KentumRIT/Lab-Air-Setup/Current-Loop-and-Pneumatic-Calibration/Images/Figures/RegulatorTransducerShielded.png

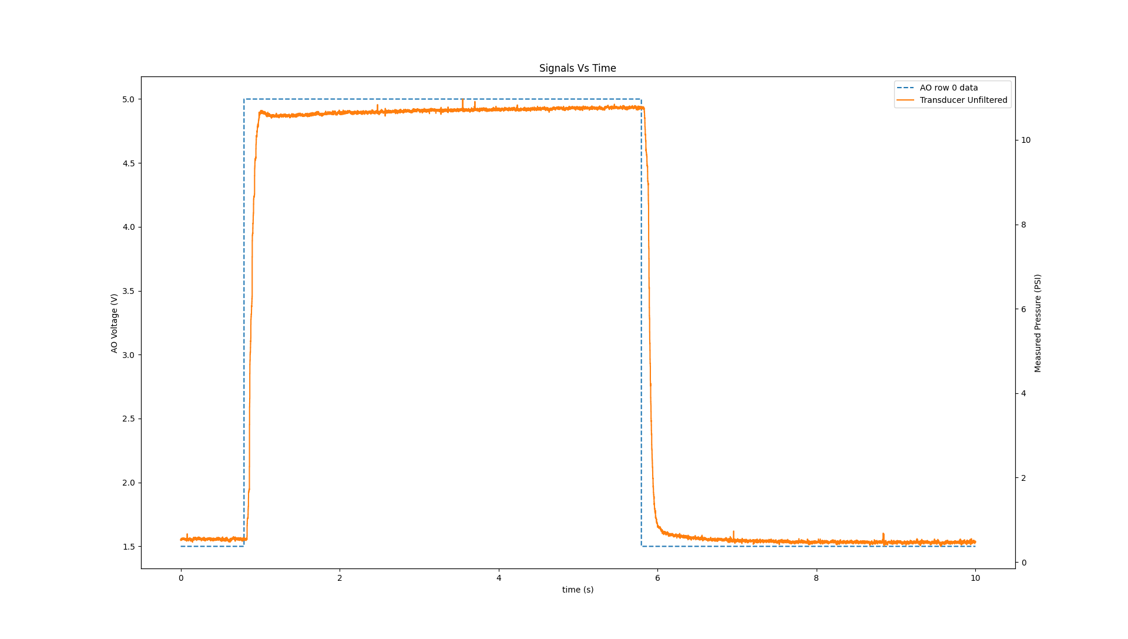
Current-Loop-and-Pneumatic-Calibration/Images/Figures/RegulatorTransducerShielded.png
