KentumRIT/Lab-Air-Setup/Current-Loop-and-Pneumatic-Calibration/Images/Figures/RegulatorTransducerUnshielded.png

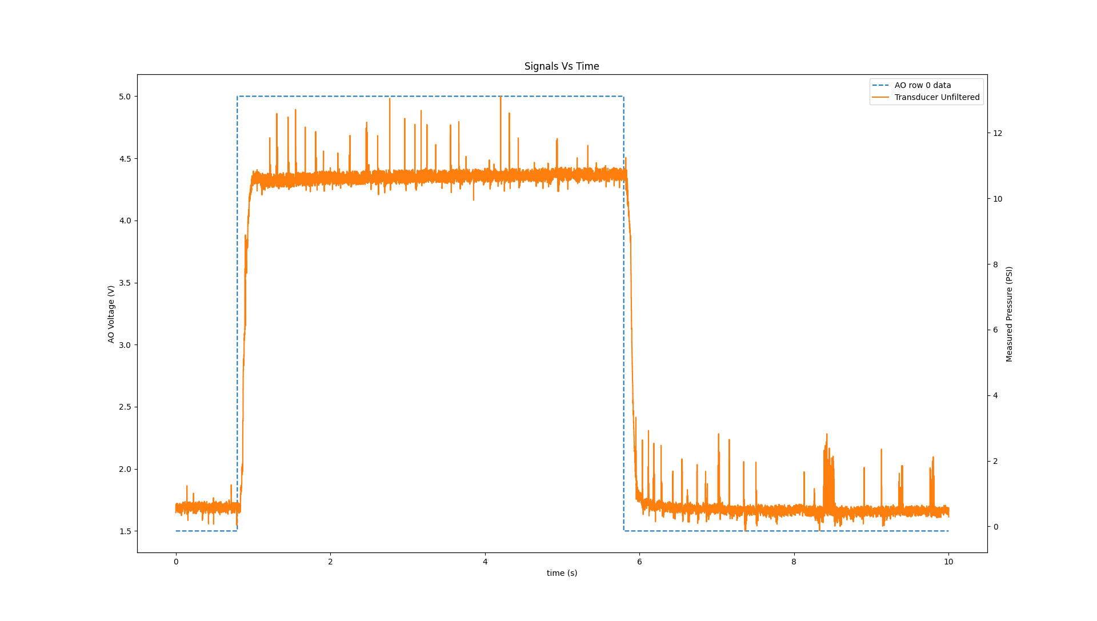
Current-Loop-and-Pneumatic-Calibration/Images/Figures/RegulatorTransducerUnshielded.png
