KentumRIT/Lab-Air-Setup/Current-Loop-Interface-Design/XTR116.asc

A1: opamp
Q1: npn
Q2: npn
R1: res; 2.475K
R2: res; 100
R3: res; 25
R4: res; 1000
R5: res; 100
R_IN: res; 20
R_LOAD: res; 250
V1: voltage; 2
V_LOOP: voltage; 24
.tran 0 2 0 0.1
