KentumRIT/Lab-Air-Setup/(commit log)

2026-05-15 Updated code & Ran current control calibration
2026-05-15 finished calibrating regulator 2
